plisco21/salem-pocket-watch/docs/images/watches-stack.jpg

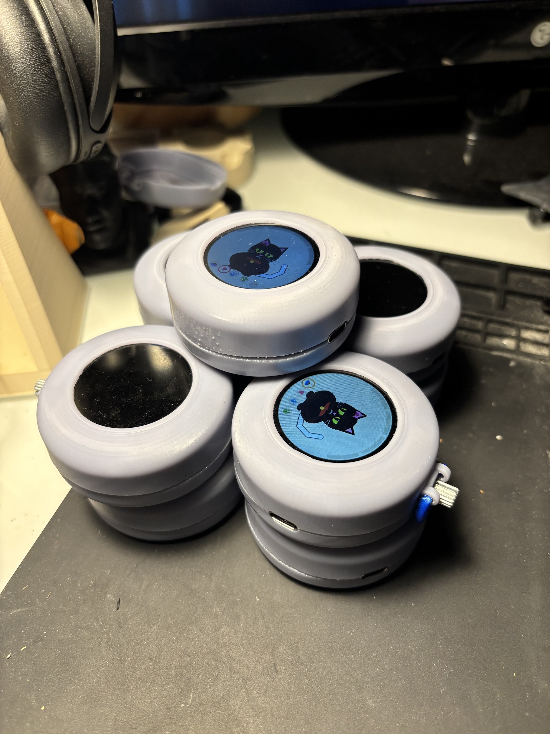
docs/images/watches-stack.jpg
