plisco21/salem-pocket-watch/docs/images/watches-standby.jpg

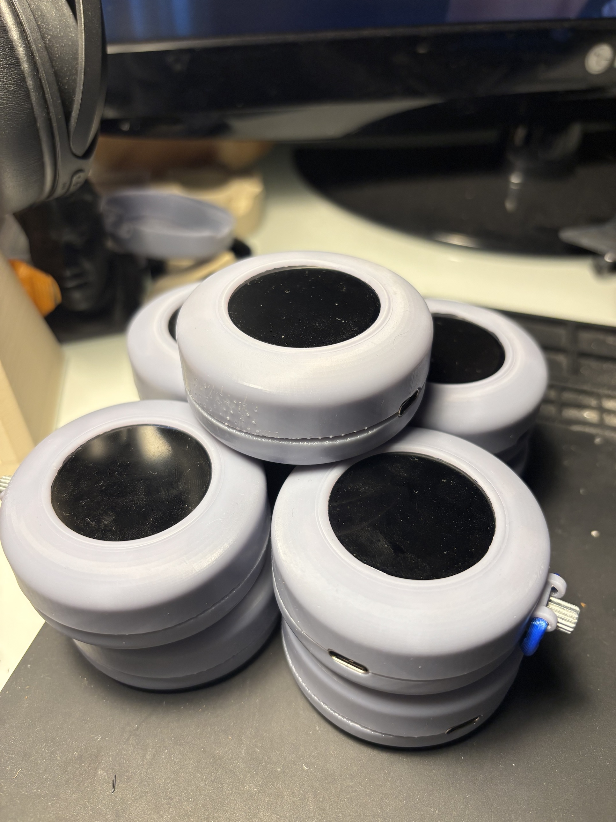
docs/images/watches-standby.jpg
