plisco21/salem-pocket-watch/firmware/salem/mappa.h

// Mappa di esempio (disegnata da script), 240x240, colori RGB565 a 16 bit.
// Sostituirla con la mappa del proprio gioco (stesso formato).
#pragma once
#include <stdint.h>

static const uint16_t mappa[57600] = {
  0xD67B, 0xDEBA, 0xDEBA, 0xDEBA, 0xDEBA, 0xDEBA, 0xDEBA, 0xDEBA, 0xDEBA, 0xDEBA, 0xDEBA, 0xDEBA, 0xDEBA, 0xDEBA, 0xDEBA, 0xDEBA,
  0xDEBA, 0xDEBA, 0xDEBA, 0xDEBA, 0xD69B, 0xDEBA, 0xDEBA, 0xDEBA, 0xDEBA, 0xDEBA, 0xDEBA, 0xDEBA, 0xDEBA, 0xDEBA, 0xDEBA, 0xDEBA,
  0xDEBA, 0xDEBA, 0xDEBA, 0xDEBA, 0xDEBA, 0xDEBA, 0xDEBA, 0xDEBA, 0xD69B, 0xDEBA, 0xDEBA, 0xDEBA, 0xDEBA, 0xDEBA, 0xDEBA, 0xDEBA,
  0xDEBA, 0xDEBA, 0xDEBA, 0xDEBA, 0xDEBA, 0xDEBA, 0xDEBA, 0xDEBA, 0xDEBA, 0xDEBA, 0xDEBA, 0xDEBA, 0xD69B, 0xDEBA, 0xDEBA, 0xDEBA,
  0xDEBA, 0xDEBA, 0xDEBA, 0xDEBA, 0xDEBA, 0xDEBA, 0xDEBA, 0xDEBA, 0xDEBA, 0xDEBA, 0xDEBA, 0xDEBA, 0xDEBA, 0xDEBA, 0xDEBA, 0xDEBA,
  0xD69B, 0xDEBA, 0xDEBA, 0xDEBA, 0xDEBA, 0xDEBA, 0xDEBA, 0xDEBA, 0xDEBA, 0xDEBA, 0xDEBA, 0xDEBA, 0xDEBA, 0xDEBA, 0xDEBA, 0xDEBA,
  0xDEBA, 0xDEBA, 0xDEBA, 0xDEBA, 0xD69B, 0xDEBA, 0xDEBA, 0xDEBA, 0xDEBA, 0xDEBA, 0xDEBA, 0xDEBA, 0xDEBA, 0xDEBA, 0xDEBA, 0xDEBA,
  0xDEBA, 0xDEBA, 0xDEBA, 0xDEBA, 0xDEBA, 0xDEBA, 0xDEBA, 0xDEBA, 0xD69B, 0xDEBA, 0xDEBA, 0xDEBA, 0xDEBA, 0xDEBA, 0xDEBA, 0xDEBA,
  0xDEBA, 0xDEBA, 0xDEBA, 0xDEBA, 0xDEBA, 0xDEBA, 0xDEBA, 0xDEBA, 0xDEBA, 0xDEBA, 0xDEBA, 0xDEBA, 0xD69B, 0xDEBA, 0xDEBA, 0xDEBA,
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
  0xEF18, 0xEF18, 0xEF18, 0xEF18, 0xEF18, 0xEF18, 0xEF18, 0xEF18, 0xEF18, 0xEF18, 0xEF18, 0xEEF9, 0xDEBA, 0xEF38, 0xEF18, 0xEF18,
  0xEF18, 0xEF18, 0xEF18, 0xEF18, 0xEF18, 0xEF18, 0xEF18, 0xEF18, 0xEF18, 0xEF18, 0xEF18, 0xEF18, 0xEF18, 0xEF18, 0xEF18, 0xEEF9,
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
};
